AtharZafeer/solardatalogger/Schematic/SabotSchematic.pdf

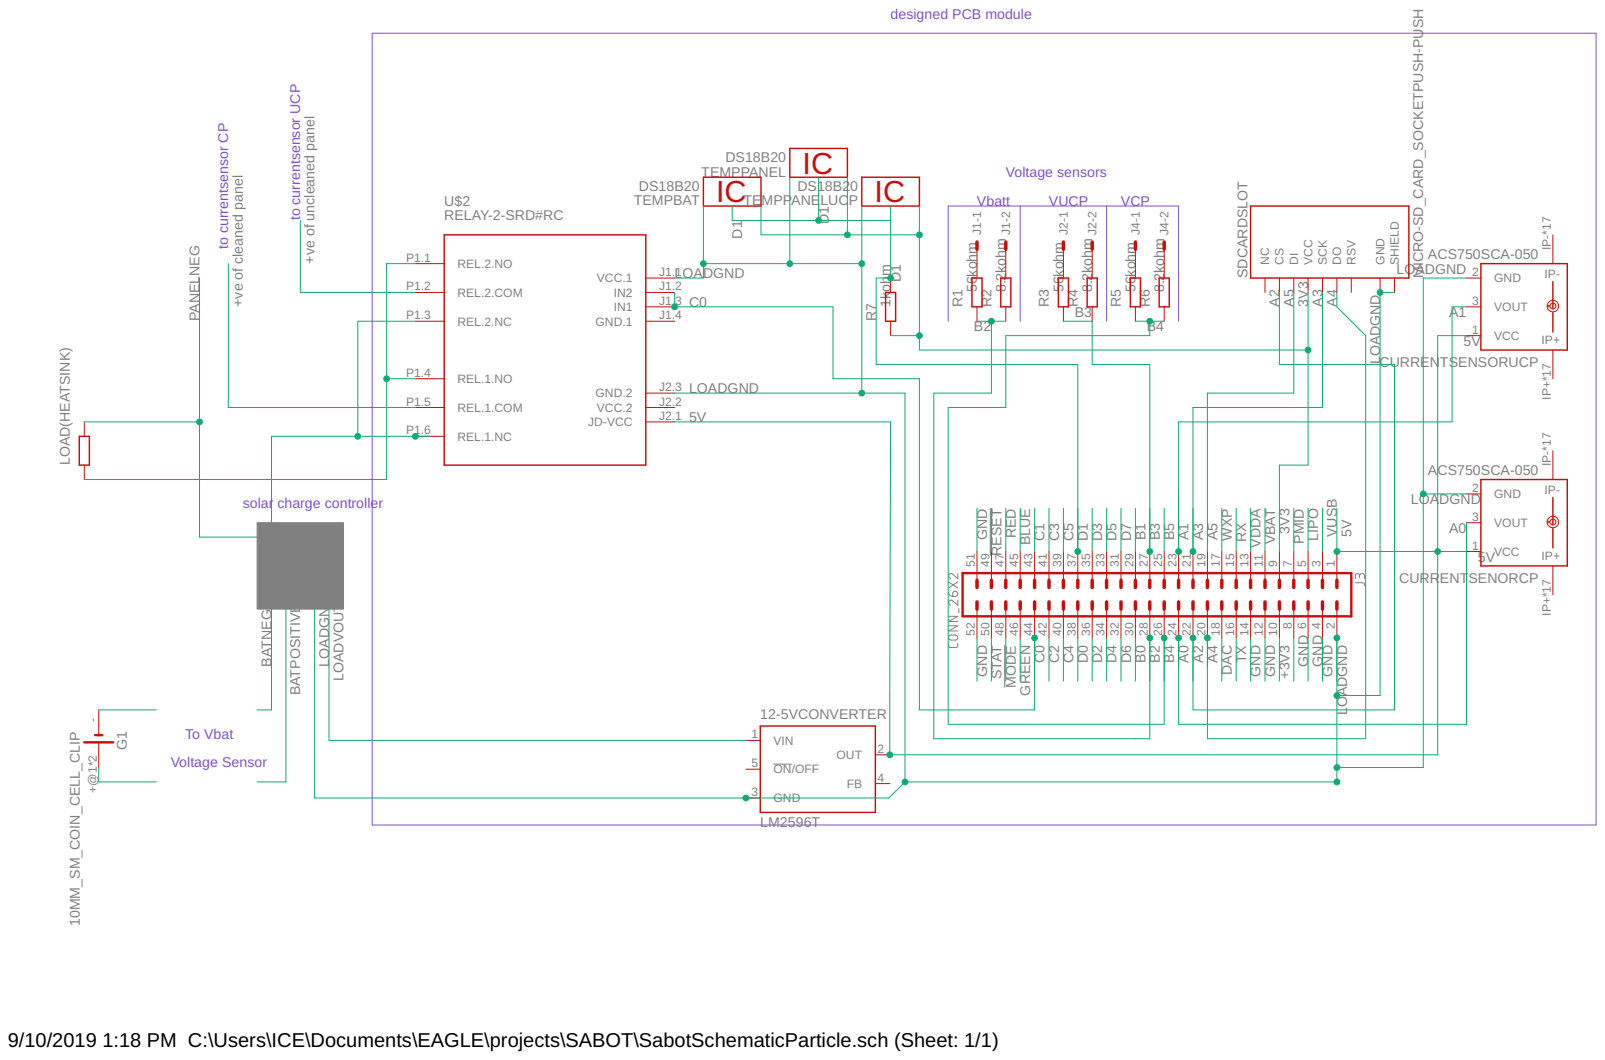
[picture p11: page 1]

Voltage sensors +ve of uncleaned panel

+ve of cleaned panel

STAT RESET BLUE GREEN

9/10/2019 1:18 PM C:\Users\ICE\Documents\EAGLE\projects\SABOT\SabotSchematicParticle.sch (Sheet: 1/1)
