AtharZafeer/solardatalogger/Schematic/SabotSchematicParticle.sch

## EAGLE design Schematic/SabotSchematicParticle.sch (2019-09-09)

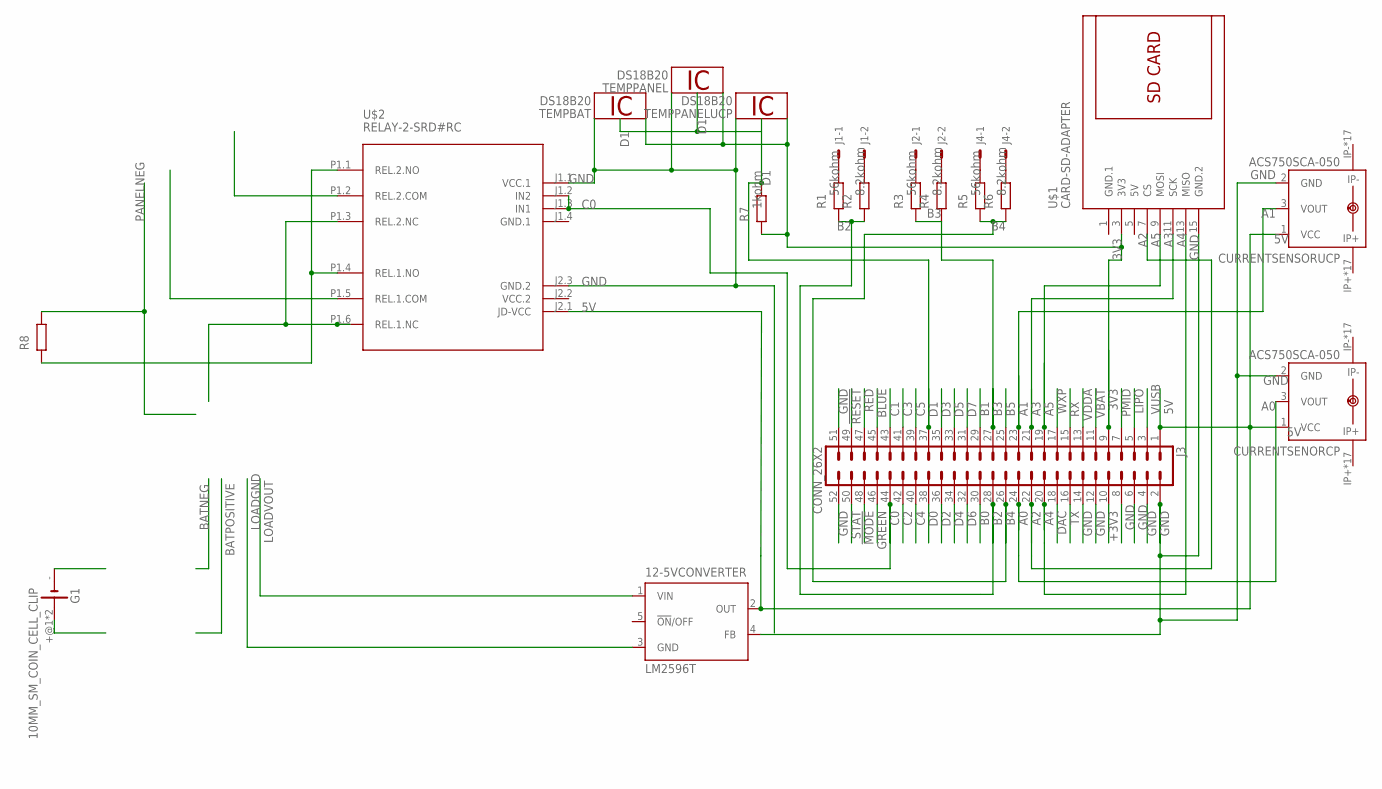
[picture p12: schematic SabotSchematicParticle.sch]

Parts:
12-5VCONVERTER: LM2596T; T05D
CURRENTSENORCP: ACS750SCA-050; ACS75050
CURRENTSENSORUCP: ACS750SCA-050; ACS75050
G1: 10MM_SM_COIN_CELL_CLIP
J1, J2, J4: 22-27-2021-02; 6410-02
J3: CONN_26X2; 2X26
TEMPBAT: DS18B20; TO92-
TEMPPANEL: DS18B20; TO92-
TEMPPANELUCP: DS18B20; TO92-
U$1: CARD-SD-ADAPTER
U$2: RELAY-2-SRD#RC

Connections:
3V3: J3.9, U$1.3 (3V3)
5V: 12-5VCONVERTER.2 (OUT), CURRENTSENORCP.1 (VCC), CURRENTSENSORUCP.1 (VCC), J3.1, U$2.J2.1 (JD-VCC)
!MODE: J3.48
!RESET: J3.49
+3V3: J3.10
A0: CURRENTSENORCP.3 (VOUT), J3.24
A1: CURRENTSENSORUCP.3 (VOUT), J3.23
A2: J3.22, U$1.7 (CS)
A3: J3.21, U$1.11 (SCK)
A4: J3.20, U$1.13 (MISO)
A5: J3.19, U$1.9 (MOSI)
B0: J3.30
B1: J3.29
B2: J3.28
B3: J3.27
B4: J3.26
B5: J3.25
BLUE: J3.45
C0: J3.44, U$2.J1.2 (IN2), U$2.J1.3 (IN1)
C1: J3.43
C2: J3.42
C3: J3.41
C4: J3.40
C5: J3.39
D0: J3.38
D1: J3.37
D2: J3.36
D3: J3.35
D4: J3.34
D5: J3.33
D6: J3.32
D7: J3.31
DAC: J3.18
GND: 12-5VCONVERTER.4 (FB), CURRENTSENORCP.2 (GND), CURRENTSENSORUCP.2 (GND), J3.2, J3.4, J3.6, J3.8, J3.12, J3.14, J3.51, J3.52, U$1.15 (GND.2), U$2.J1.1 (VCC.1), U$2.J2.3 (GND.2)
GREEN: J3.46
LIPO: J3.5
LOADGND: 12-5VCONVERTER.3 (GND)
LOADVOUT: 12-5VCONVERTER.1 (VIN)
unnamed: U$2.P1.3 (REL.2.NC), U$2.P1.6 (REL.1.NC)
unnamed: U$2.P1.1 (REL.2.NO), U$2.P1.4 (REL.1.NO)
PMID: J3.7
RED: J3.47
RX: J3.15
STAT: J3.50
TX: J3.16
VBAT: J3.11
VDDA: J3.13
VUSB: J3.3
WXP: J3.17
