AtharZafeer/solardatalogger/functions/RelayTester.ino

void setup() {
  pinMode(D2, OUTPUT);
  pinMode(D3, OUTPUT);
  pinMode(D4, OUTPUT);

}
void loop() {
  digitalWrite(D2, HIGH);
  digitalWrite(D3, HIGH);
  digitalWrite(D4, HIGH);
  delay(5000);
  digitalWrite(D2, LOW);
  digitalWrite(D3, LOW);
  digitalWrite(D4, LOW);
  delay(5000);

}
