AtharZafeer/solardatalogger/(commit log)

2019-09-09 add schematics and some comments
    [SabotSchematicParticle.sch]
2019-09-10 add comments, new temperature sensor code and datasheets
2019-09-10 add schematics pdf
